maxmodapp/Smart-alarm-system/docs/DEMOS.md

# Recorded Demos

Five recordings document the working prototype. They are included in `docs/videos/` and tracked with Git LFS because several exceed GitHub's standard 100 MB per-file limit.

| Recording | Content | Approximate size |
| --- | --- | ---: |
| [CONEXION.mp4](videos/CONEXION.mp4) | Gateway configuration and connection flow. | 82.1 MB |
| [PANEL PRINCIPAL.mp4](videos/PANEL%20PRINCIPAL.mp4) | Main panel, arming, disarming, and state transitions. | 207.3 MB |
| [ZONAS.mp4](videos/ZONAS.mp4) | Individual zone enable/disable controls. | 168.3 MB |
| [HISTORIAL.mp4](videos/HISTORIAL.mp4) | Event history retrieval and display. | 106.1 MB |
| [EXTRA.mp4](videos/EXTRA.mp4) | Additional prototype demonstration. | 68.3 MB |

The recordings show the main mobile workflows and the integration with the physical alarm hardware.
