maxmodapp/Smart-alarm-system/firmware/esp32-cam/secrets.example.h

#pragma once

// Copy this file to `secrets.h` and enter your 2.4 GHz Wi-Fi credentials.
// `secrets.h` is ignored by Git to prevent credentials from being published.
#define WIFI_SSID "YOUR_WIFI_NETWORK"
#define WIFI_PASSWORD "YOUR_WIFI_PASSWORD"
